andrewrussellmalcolm/instrumented_garden/3D_models/1551GFL.stp

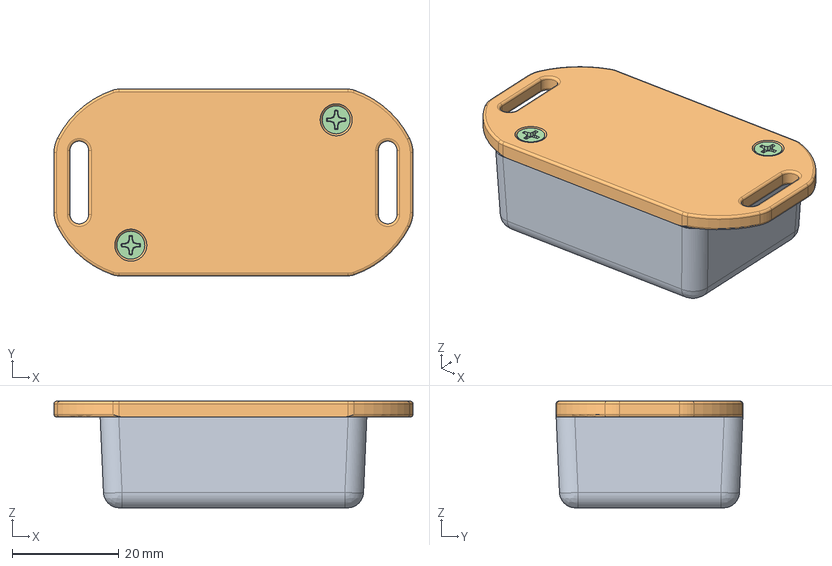
[picture p1: CAD file, 2020-08-18]
3D_models/1551GFL.stp
67.3 x 35.0 x 20.0 mm
1551G Box
1551F-G Flange Lid
1551G PCB
