andrewrussellmalcolm/instrumented_garden/3D_models/User Library-2450 Coin Cell battery.STEP

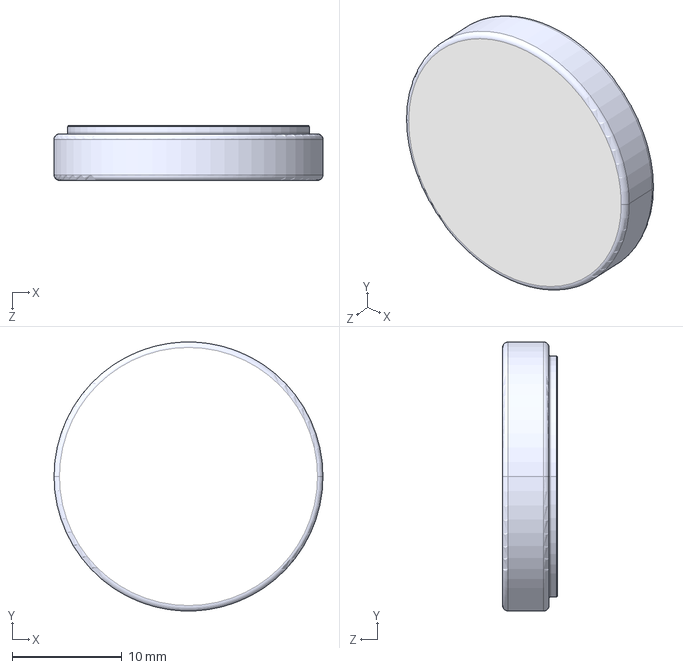
[picture p2: CAD file, 2020-08-18]
3D_models/User Library-2450 Coin Cell battery.STEP
24.5 x 24.5 x 5.00 mm
