andrewrussellmalcolm/instrumented_garden/3D_models/User Library-VEML6075.STEP

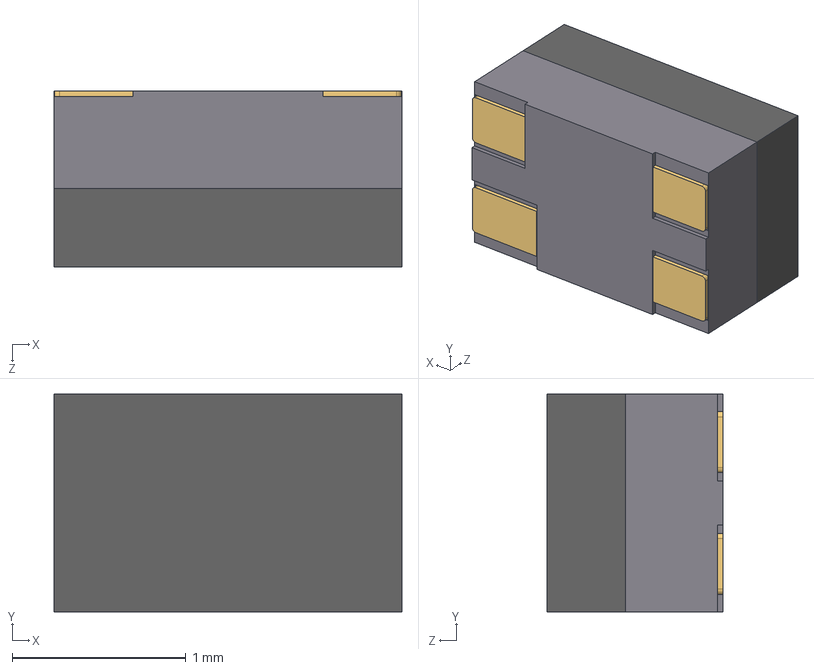
[picture p3: CAD file, 2020-08-18]
3D_models/User Library-VEML6075.STEP
2.00 x 1.25 x 1.01 mm
