andrewrussellmalcolm/instrumented_garden/3D_models/User Library-SMTU 2450N-1-LF.step

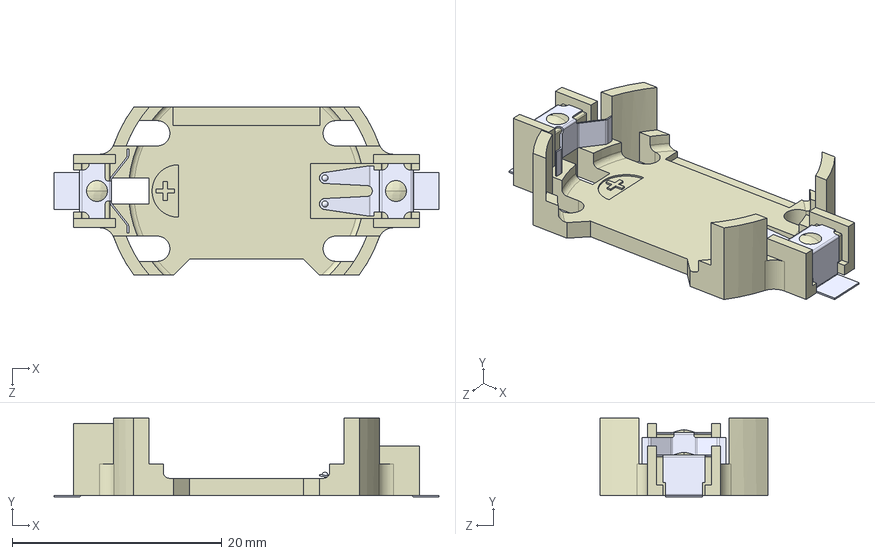
[picture p4: CAD file, 2020-08-18]
3D_models/User Library-SMTU 2450N-1-LF.step
36.7 x 7.50 x 16.0 mm
