andrewrussellmalcolm/instrumented_garden/3D_models/User Library-PG-VLGA-8-1.STEP

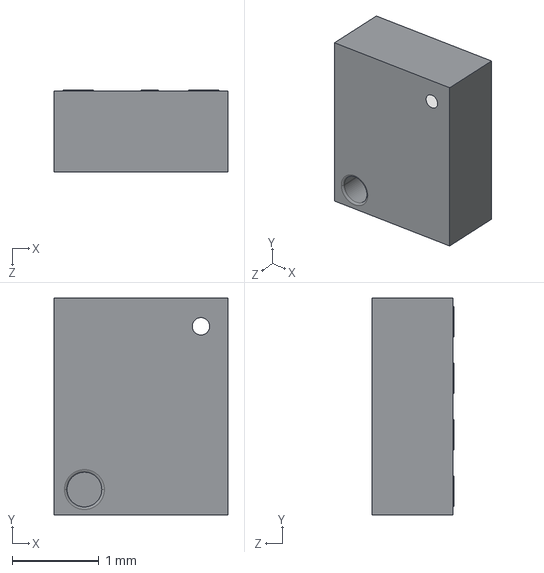
[picture p5: CAD file, 2020-08-18]
3D_models/User Library-PG-VLGA-8-1.STEP
2.00 x 2.50 x 0.94 mm
