andrewrussellmalcolm/instrumented_garden/3D_models/User Library-SW868-TH13.step

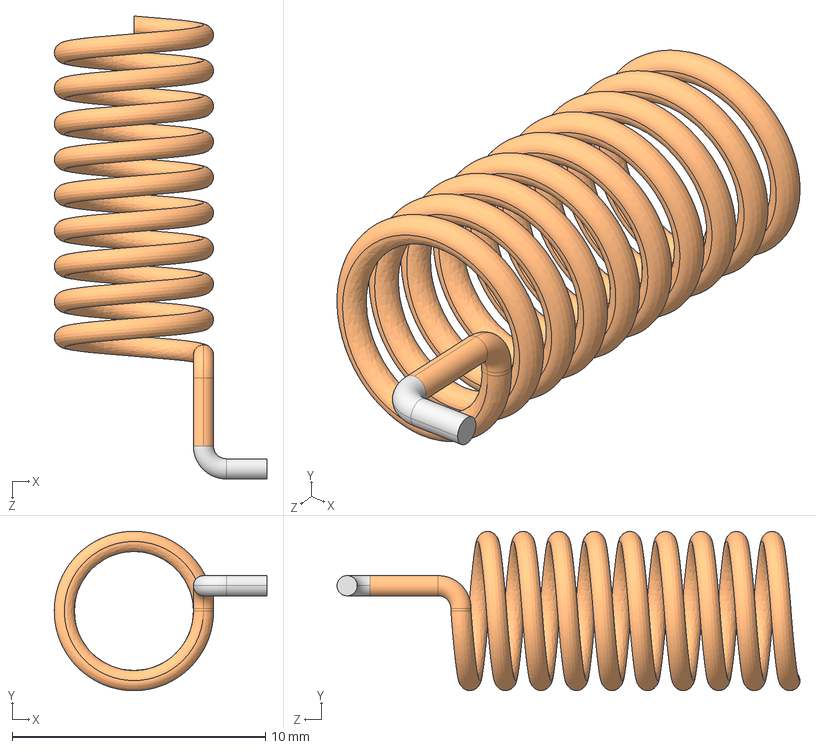
[picture p6: CAD file, 2020-08-18]
3D_models/User Library-SW868-TH13.step
8.40 x 6.30 x 18.3 mm
