andrewrussellmalcolm/instrumented_garden/LoRa-Mini.kicad_pcb

## KiCad design LoRa-Mini.kicad_pcb (2020-08-18)

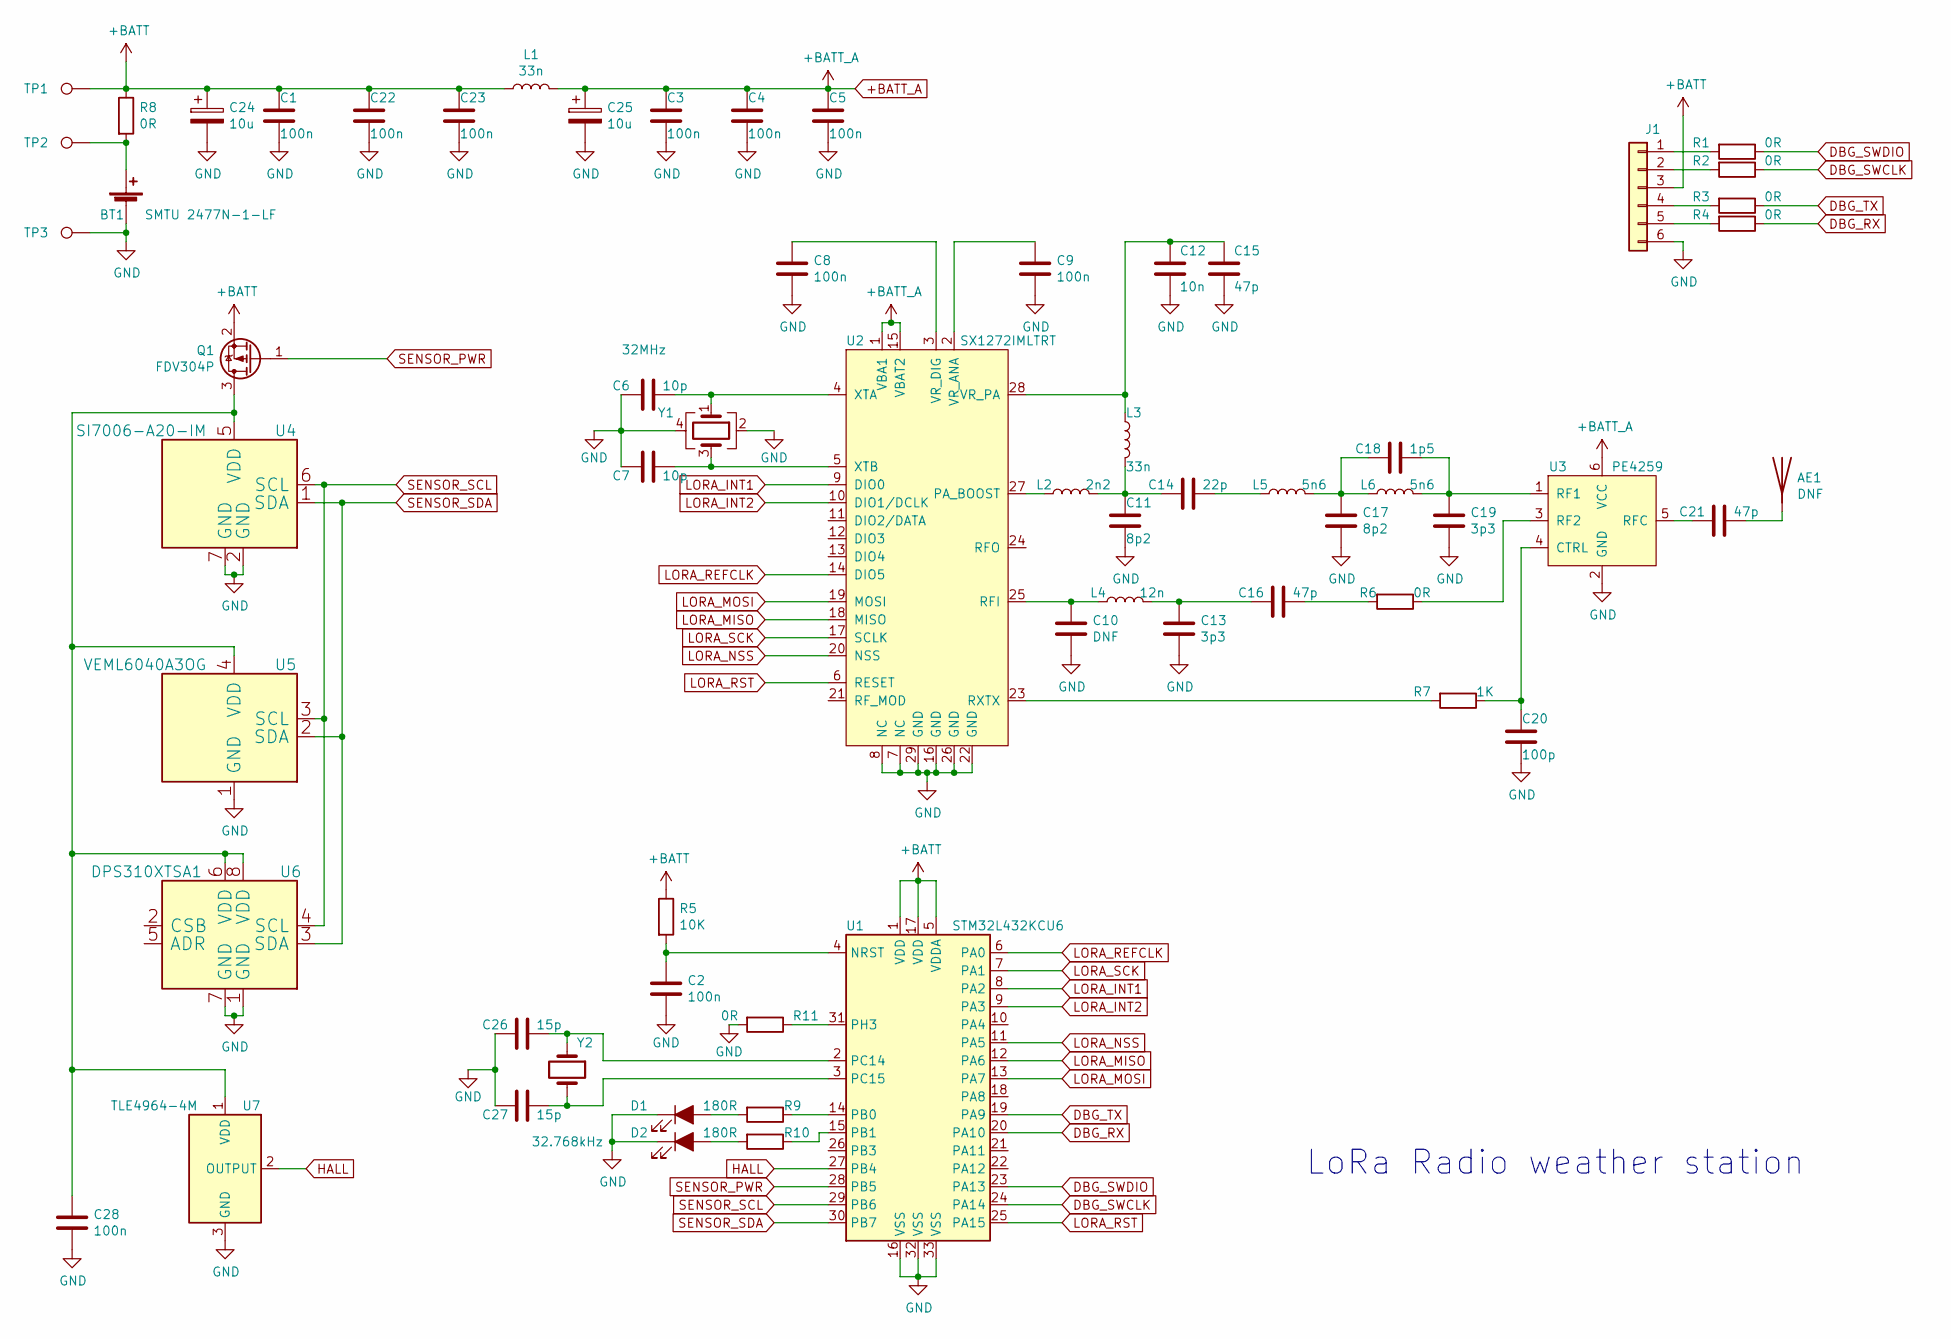
[picture p7: schematic LoRa-Mini.sch]

Parts:
AE1: DNF; SPRING_ANTENNA_868MHz
BT1: SMTU 2477N-1-LF; BatteryHolder_SMTU2477N-LF
C1, C3, C4, C5, C8, C9, C22, C23, C28: 100n; C_0603_1608Metric; Voltage 50V; PartNo C0603C104K3RACTU
C2: 100n; C_0603_1608Metric; Voltage 50V
C6, C7: 10p; C_0603_1608Metric; Voltage 50V; PartNo C0603C150J5GACTU
C10: DNF; C_0603_1608Metric
C11, C17: 8p2; C_0603_1608Metric; Voltage 50V; PartNo C0603C829C5GACTU
C12: 10n; C_0603_1608Metric; Voltage 50V; PartNo C0603C103K5RACTU
C13, C19: 3p3; C_0603_1608Metric; Voltage 50V; PartNo C0603C339C5GACTU
C14: 22p; C_0603_1608Metric; Voltage 50V; PartNo C0603C220J5GACTU
C15, C16, C21: 47p; C_0603_1608Metric; Voltage 50V; PartNo C0603C470J5GACTU
C18: 1p5; C_0603_1608Metric; Voltage 50V; PartNo C0603C159C1GACTU
C20: 100p; C_0603_1608Metric; Voltage 50V; PartNo C0603C101J5GACTU
C24, C25: 10u; CP_EIA-3216-10_Kemet-I; Voltage 6.3V
C26, C27: 15p; C_0603_1608Metric; Voltage 50V; PartNo C0603C150J5GACTU
D1: LTST-C190KRKT; D_0603_1608Metric
D2: LTST-C190KGKT; D_0603_1608Metric
J1: Conn_01x06; PinHeader_1x06_P2.54mm_Vertical
L1, L3: 33n; L_0603_1608Metric; PartNo LQW18AN33NJ10D
L2: 2n2; L_0603_1608Metric; PartNo LQW18AN2N2D10D
L4: 12n; L_0603_1608Metric; PartNo LQW18AN12NG10D
L5, L6: 5n6; L_0603_1608Metric; PartNo LQW18AN5N6D10D
Q1: FDV304P; SOT-23
R1, R2, R3, R4, R8, R11: 0R; R_0603_1608Metric
R5: 10K; R_0603_1608Metric
R6: 0R; R_0603_1608Metric; PartNo CRG0603ZR
R7: 1K; R_0603_1608Metric; PartNo CRG0603F1K0
R9, R10: 180R; R_0603_1608Metric
TP1, TP2, TP3: DNF; TestPoint_Pad_D2.0mm
U1: STM32L432KCU6; QFN-32-1EP_5x5mm_P0.5mm_EP3.45x3.45mm
U2: SX1272IMLTRT; QFN-28-1EP_6x6mm_P0.65mm_EP4.8x4.8mm_ThermalVias
U3: PE4259; SOT-363_SC-70-6
U4: SI7006-A20-IM; DFN-6-1EP_3x3mm_P1mm_EP1.5x2.4mm
U5: VEML6040A3OG; OPLGA
U6: DPS310XTSA1; PG-VGA-8-1
U7: TLE4964-4M; SOT-23
Y1: 32MHz; Crystal_SMD_2016-4Pin_2.0x1.6mm; PartNo Q22FA1280002511
Y2: 32.768kHz; Crystal_SMD_MicroCrystal_CC8V-T1A-2Pin_2.0x1.2mm_HandSolder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

Connections:
+BATT: C1.1, C22.1, C23.1, C24.1, J1.3, L1.1, Q1.2 (S), R5.1, R8.1, TP1.1, U1.1 (VDD), U1.5 (VDDA), U1.17 (VDD)
+BATT_A: C3.1, C4.1, C5.1, C25.1, L1.2, U2.1 (VBA1), U2.15 (VBAT2), U3.6 (VCC)
DBG_RX: R4.1, U1.20 (PA10)
DBG_SWCLK: R2.1, U1.24 (PA14)
DBG_SWDIO: R1.1, U1.23 (PA13)
DBG_TX: R3.1, U1.19 (PA9)
GND: BT1.2 (-), C1.2, C2.2, C3.2, C4.2, C5.2, C6.2, C7.2, C8.2, C9.2, C10.2, C11.2, C12.2, C13.2, C15.2, C17.2, C19.2, C20.2, C22.2, C23.2, C24.2, C25.2, C26.2, C27.2, C28.2, D1.1 (K), D2.1 (K), J1.6, R11.2, TP3.1, U1.16 (VSS), U1.32 (VSS), U1.33 (VSS), U2.7 (NC), U2.8 (NC), U2.16 (GND), U2.22 (GND), U2.26 (GND), U2.29 (GND), U3.2 (GND), U4.2 (GND), U4.7 (GND), U5.1 (GND), U6.1 (GND), U6.7 (GND), U7.3 (GND), Y1.2, Y1.4
HALL: U1.27 (PB4), U7.2 (OUTPUT)
LORA_INT1: U1.8 (PA2), U2.9 (DIO0)
LORA_INT2: U1.9 (PA3), U2.10 (DIO1/DCLK)
LORA_MISO: U1.12 (PA6), U2.18 (MISO)
LORA_MOSI: U1.13 (PA7), U2.19 (MOSI)
LORA_NSS: U1.11 (PA5), U2.20 (NSS)
LORA_REFCLK: U1.6 (PA0), U2.14 (DIO5)
LORA_RST: U1.25 (PA15), U2.6 (RESET)
LORA_SCK: U1.7 (PA1), U2.17 (SCLK)
unnamed: AE1.1, C21.1
unnamed: BT1.1 (+), R8.2, TP2.1
unnamed: C2.1, R5.2, U1.4 (NRST)
unnamed: C6.1, U2.4 (XTA), Y1.1
unnamed: C7.1, U2.5 (XTB), Y1.3
unnamed: C8.1, U2.3 (VR_DIG)
unnamed: C9.1, U2.2 (VR_ANA)
unnamed: C10.1, L4.1, U2.25 (RFI)
unnamed: C11.1, C14.2, L2.2, L3.2
unnamed: C12.1, C15.1, L3.1, U2.28 (VR_PA)
unnamed: C13.1, C16.2, L4.2
unnamed: C14.1, L5.1
unnamed: C16.1, R6.2
unnamed: C17.1, C18.2, L5.2, L6.1
unnamed: C18.1, C19.1, L6.2, U3.1 (RF1)
unnamed: C20.1, R7.1, U3.4 (CTRL)
unnamed: C21.2, U3.5 (RFC)
unnamed: C26.1, U1.2 (PC14), Y2.1
unnamed: C27.1, U1.3 (PC15), Y2.2
unnamed: C28.1, Q1.3 (D), U4.5 (VDD), U5.4 (VDD), U6.6 (VDD), U6.8 (VDD), U7.1 (VDD)
unnamed: D1.2 (A), R9.2
unnamed: D2.2 (A), R10.2
unnamed: J1.1, R1.2
unnamed: J1.2, R2.2
unnamed: J1.4, R3.2
unnamed: J1.5, R4.2
unnamed: L2.1, U2.27 (PA_BOOST)
unnamed: R6.1, U3.3 (RF2)
unnamed: R7.2, U2.23 (RXTX)
unnamed: R9.1, U1.14 (PB0)
unnamed: R10.1, U1.15 (PB1)
unnamed: R11.1, U1.31 (PH3)
SENSOR_PWR: Q1.1 (G), U1.28 (PB5)
SENSOR_SCL: U1.29 (PB6), U4.6 (SCL), U5.3 (SCL), U6.4 (SCL)
SENSOR_SDA: U1.30 (PB7), U4.1 (SDA), U5.2 (SDA), U6.3 (SDA)

Notes on the sheet:
LoRa Radio weather station

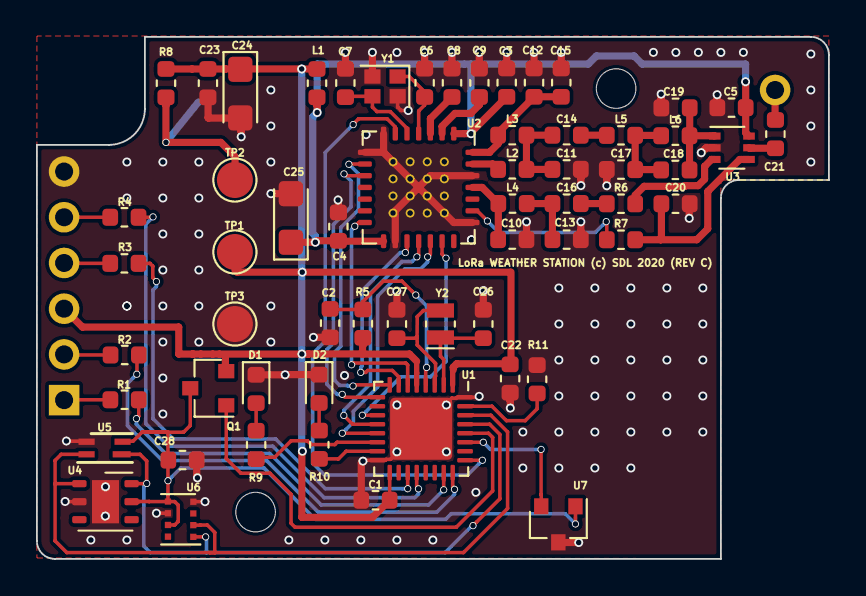
[picture p8: board LoRa-Mini.kicad_pcb from above]

Board: 2 copper layers, 44.0 x 29.0 mm, 65 parts (0 on the bottom side), 51 nets.

Other parts of the board:
MOUNTING_HOLE 2.2mm, MOUNTING_HOLE 2.2mm#2: VAL**; MOUNTING_HOLE_2.2mm
